Gadgik/vsosh-vertical-plotter/hardware/esp32/block-diagram.pdf

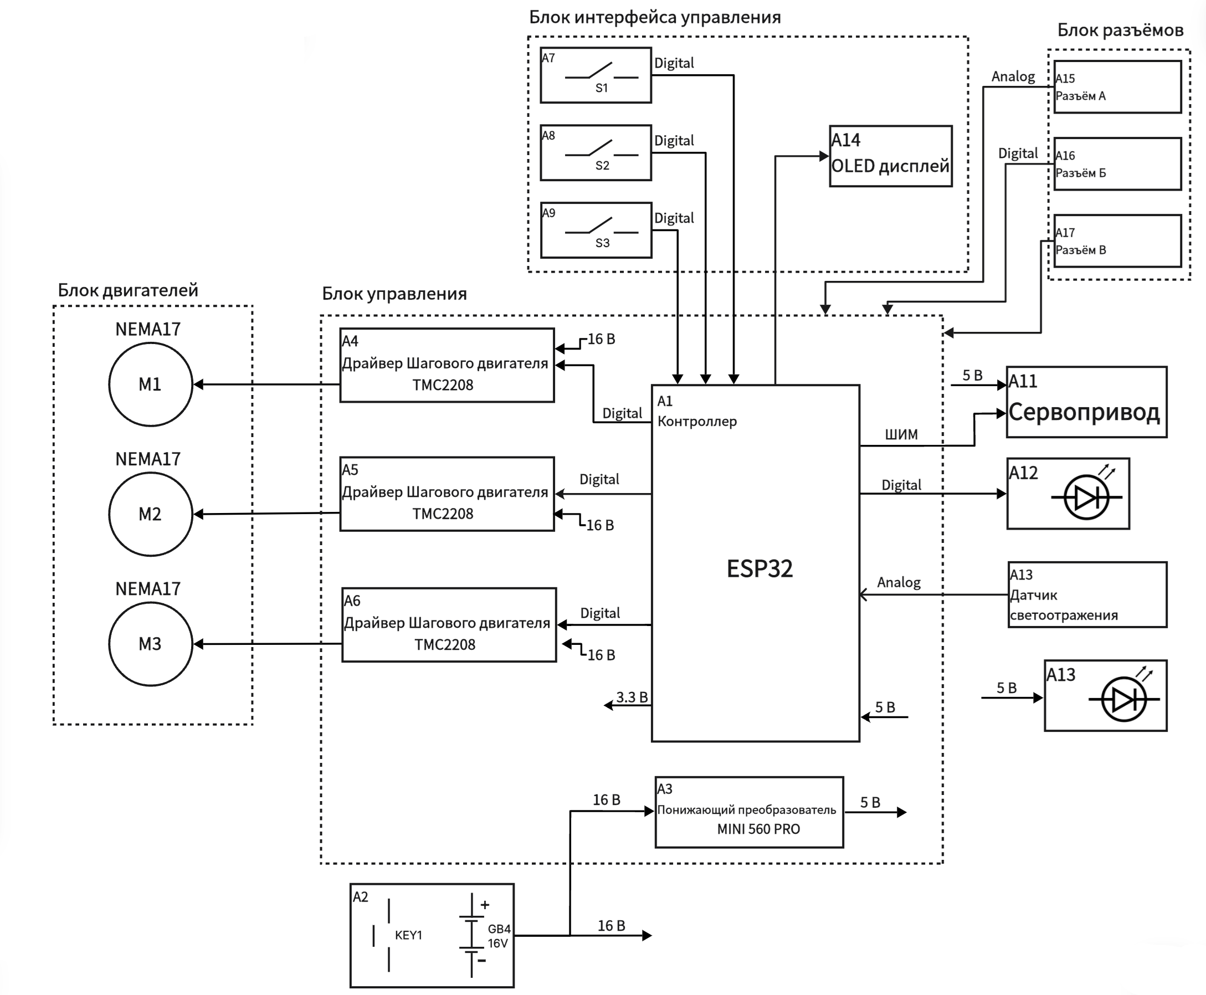
[picture p3: page 1]
