Gadgik/vsosh-vertical-plotter/hardware/PCB1.jpg

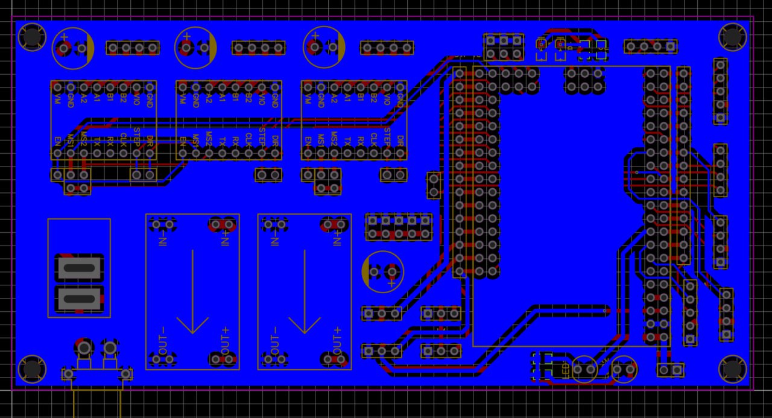
hardware/PCB1.jpg
