Gadgik/vsosh-vertical-plotter/photos/front.jpg

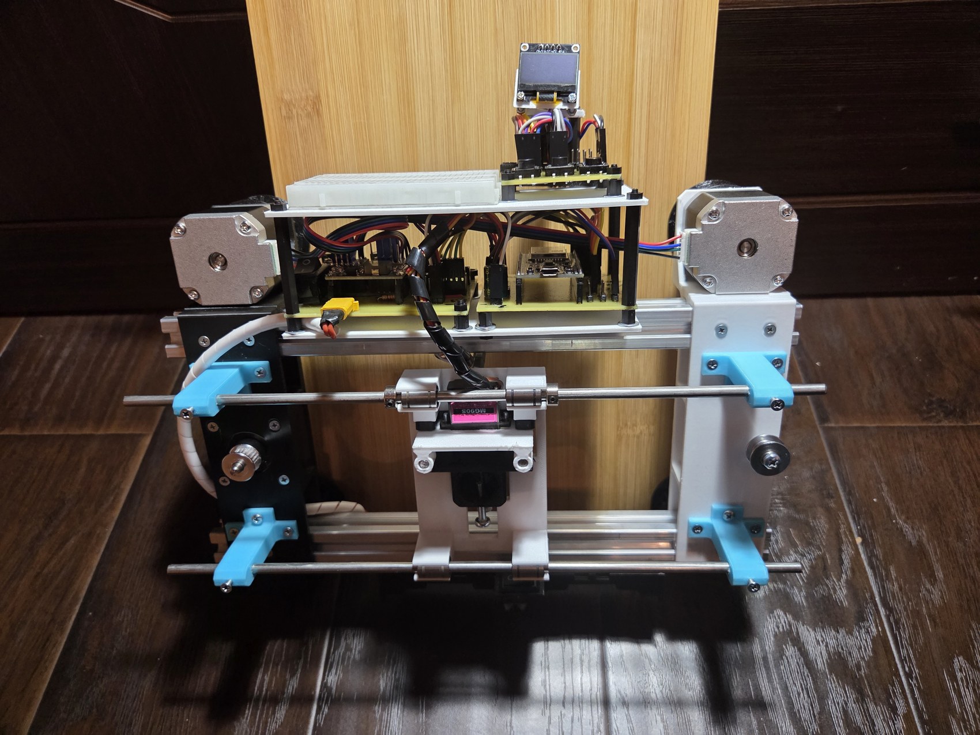
photos/front.jpg
