Gadgik/vsosh-vertical-plotter/photos/perspective.jpg

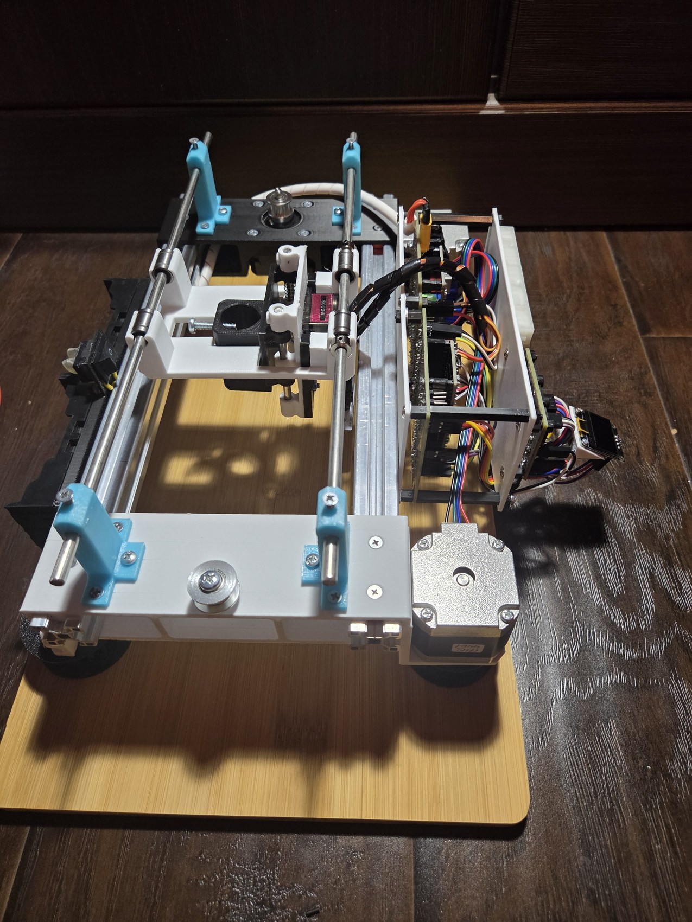
photos/perspective.jpg
