Gadgik/vsosh-vertical-plotter/photos/pic_ (2).jpg

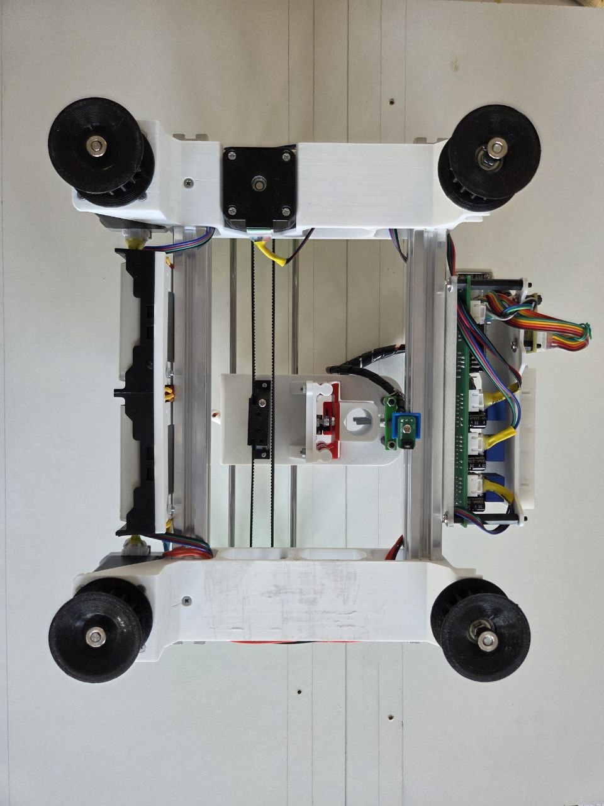
photos/pic_ (2).jpg
