Gadgik/vsosh-vertical-plotter/photos/pic_ (3).jpg

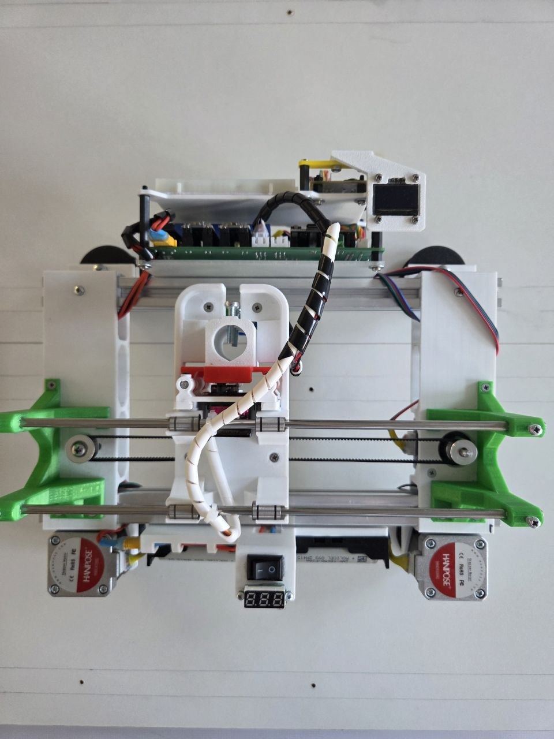
photos/pic_ (3).jpg
