Gadgik/vsosh-vertical-plotter/photos/top.jpg

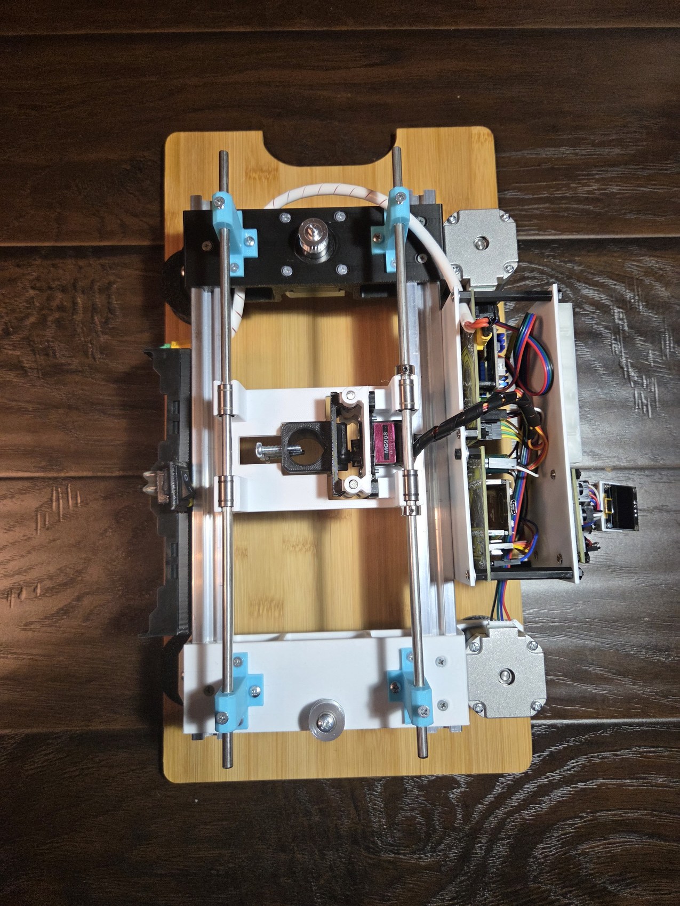
photos/top.jpg
