Gadgik/vsosh-vertical-plotter/photos/underside.jpg

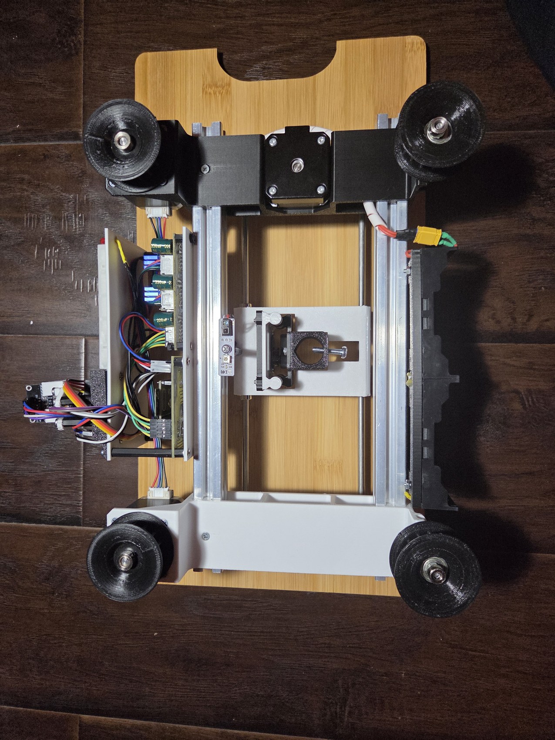
photos/underside.jpg
