Gadgik/vsosh-vertical-plotter/cad/assembly.step

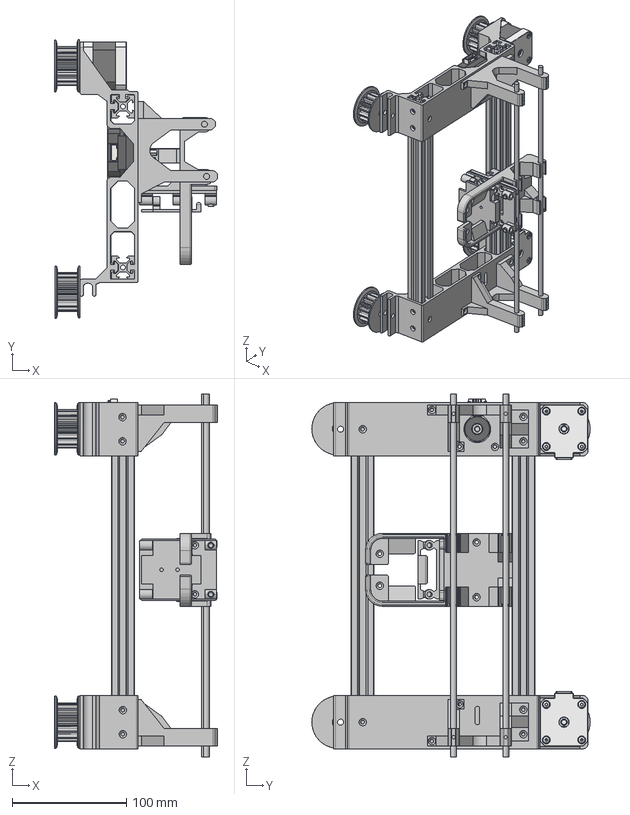
[picture p11: CAD file, 2026-11-09]
cad/assembly.step
143.0 x 244.0 x 318.0 mm
Perfil2020 x 2
back_plate
front_plate
stator
625ZZ x 2
rotor
connector
M3_screw x 4
