Gadgik/vsosh-vertical-plotter/cad/parts/screen_1.stp

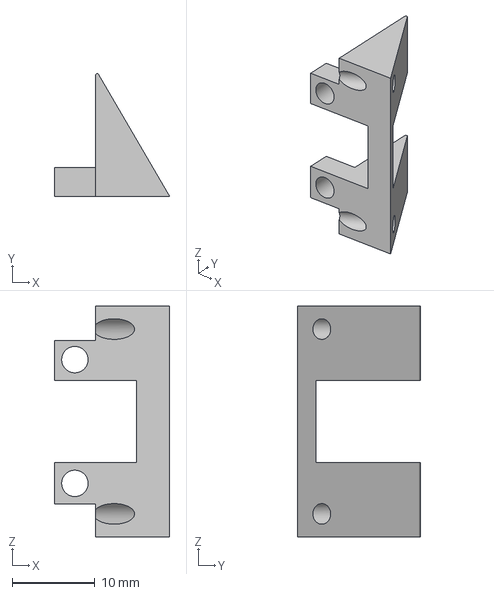
[picture p12: CAD file, 2026-11-09]
cad/parts/screen_1.stp
14.0 x 14.9 x 28.0 mm
