Gadgik/vsosh-vertical-plotter/cad/parts/z_1.stp

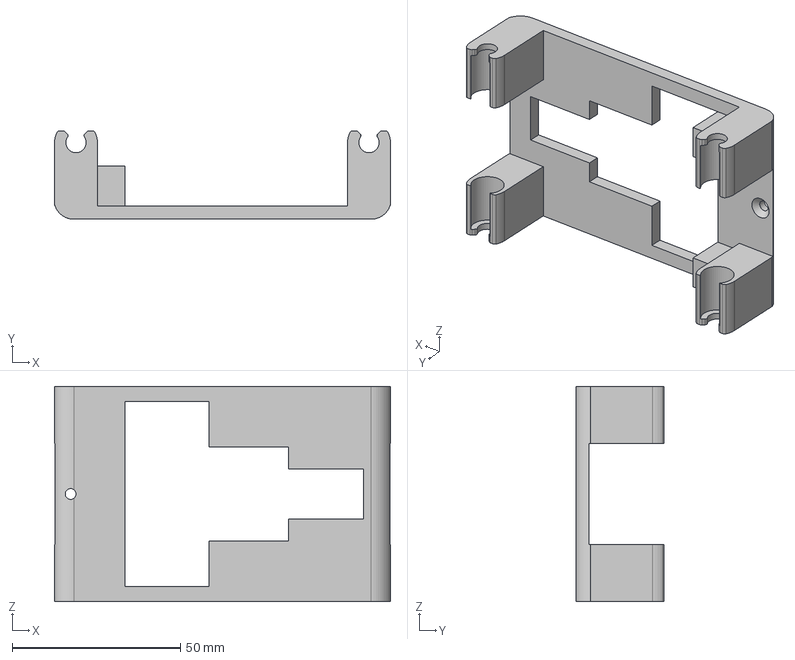
[picture p13: CAD file, 2026-11-09]
cad/parts/z_1.stp
100.0 x 26.3 x 64.0 mm
