Gadgik/vsosh-vertical-plotter/cad/parts/pcb_layer_2.stp

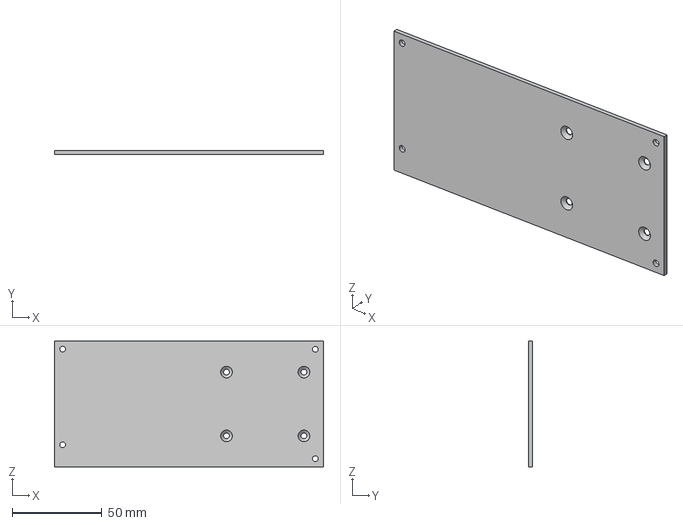
[picture p14: CAD file, 2026-11-09]
cad/parts/pcb_layer_2.stp
150.0 x 2.00 x 70.2 mm
