Gadgik/vsosh-vertical-plotter/cad/parts/Battery_hold.stp

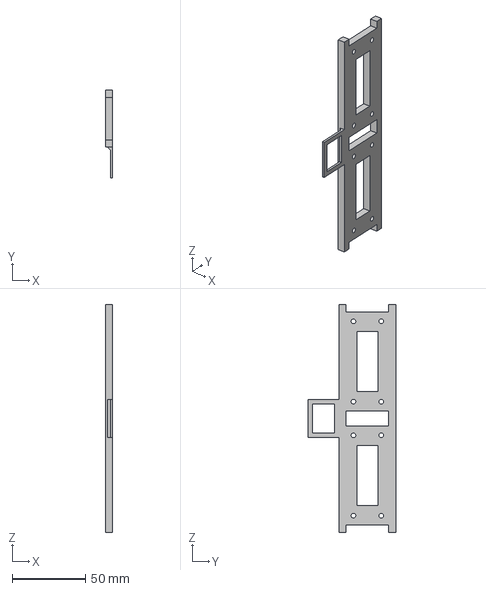
[picture p15: CAD file, 2026-11-09]
cad/parts/Battery_hold.stp
5.00 x 60.0 x 156.0 mm
