Gadgik/vsosh-vertical-plotter/cad/parts/z_5.stp

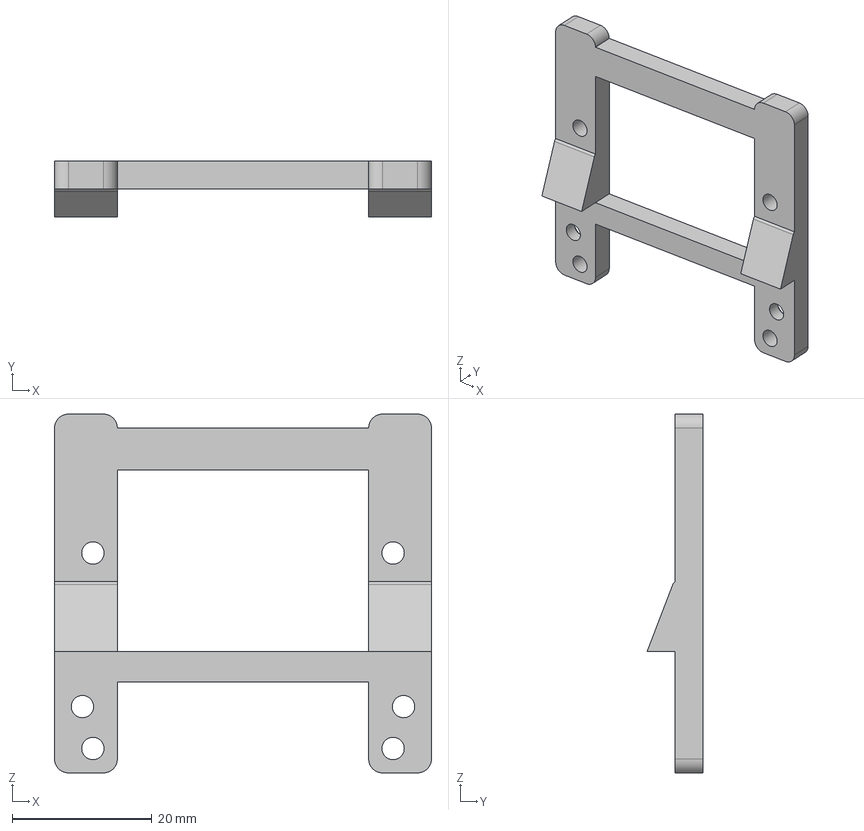
[picture p16: CAD file, 2026-11-09]
cad/parts/z_5.stp
54.0 x 8.00 x 51.4 mm
