Gadgik/vsosh-vertical-plotter/cad/parts/rail_holder.stp

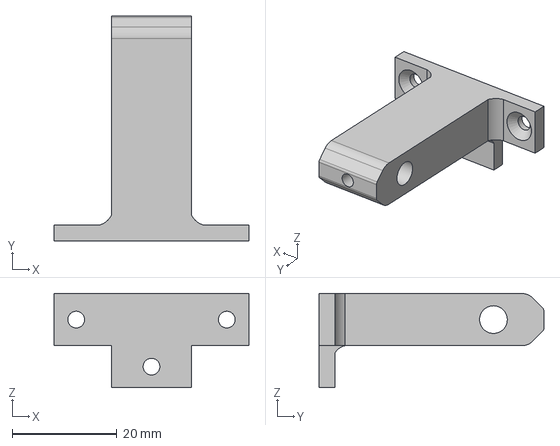
[picture p18: CAD file, 2026-11-09]
cad/parts/rail_holder.stp
37.3 x 43.0 x 18.0 mm
