Gadgik/vsosh-vertical-plotter/cad/parts/z_4.stp

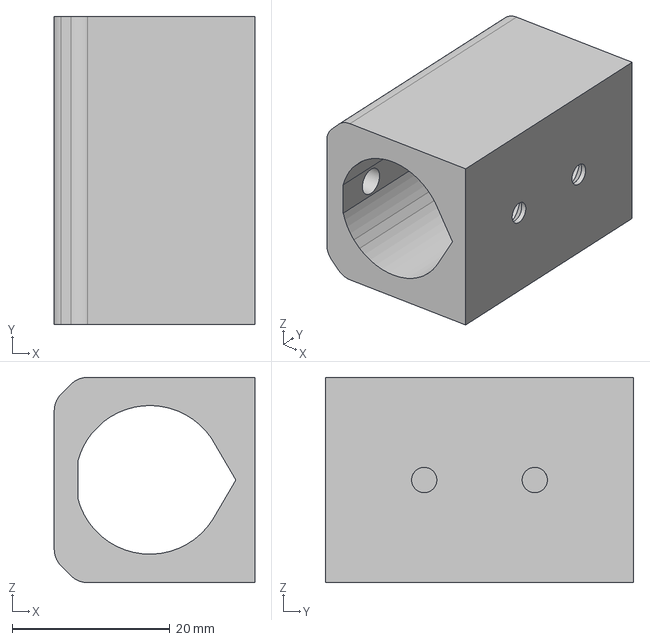
[picture p19: CAD file, 2026-11-09]
cad/parts/z_4.stp
25.4 x 39.0 x 26.0 mm
