Gadgik/vsosh-vertical-plotter/cad/parts/gear_motor.stp

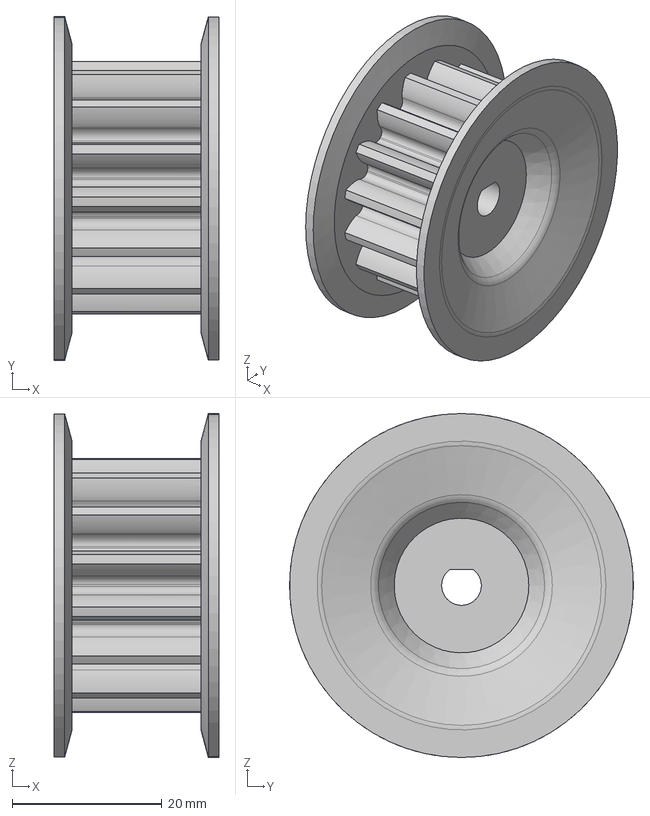
[picture p20: CAD file, 2026-11-09]
cad/parts/gear_motor.stp
22.0 x 46.0 x 46.0 mm
