Gadgik/vsosh-vertical-plotter/cad/parts/gear_op.stp

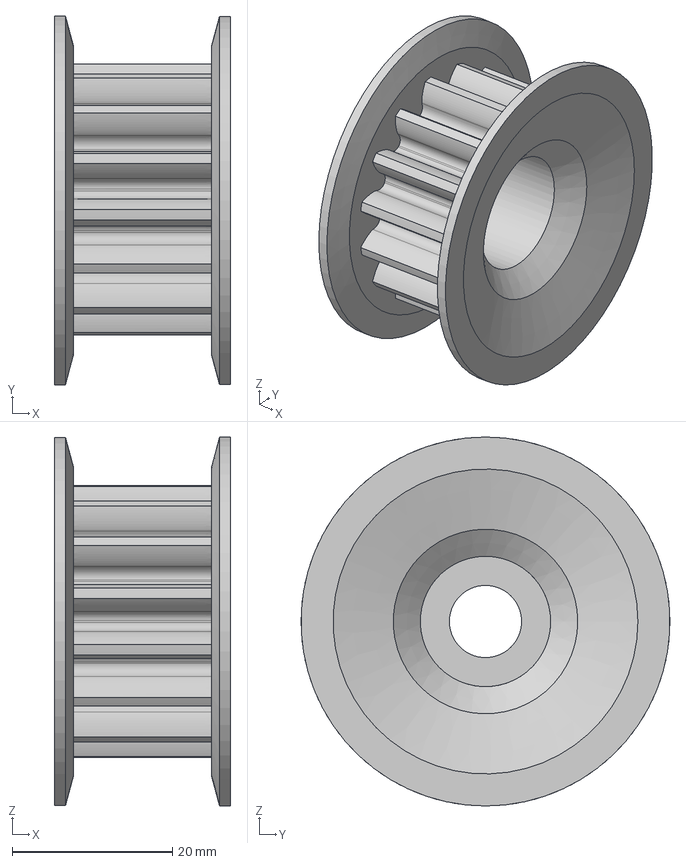
[picture p21: CAD file, 2026-11-09]
cad/parts/gear_op.stp
22.0 x 46.0 x 46.0 mm
