Gadgik/vsosh-vertical-plotter/cad/parts/motor_holder_R_2.stp

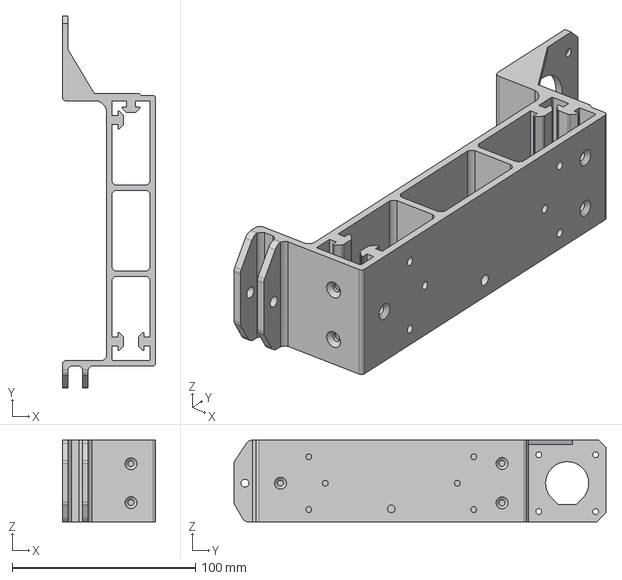
[picture p22: CAD file, 2026-11-09]
cad/parts/motor_holder_R_2.stp
50.8 x 202.9 x 44.7 mm
