Gadgik/vsosh-vertical-plotter/cad/parts/screen_2.stp

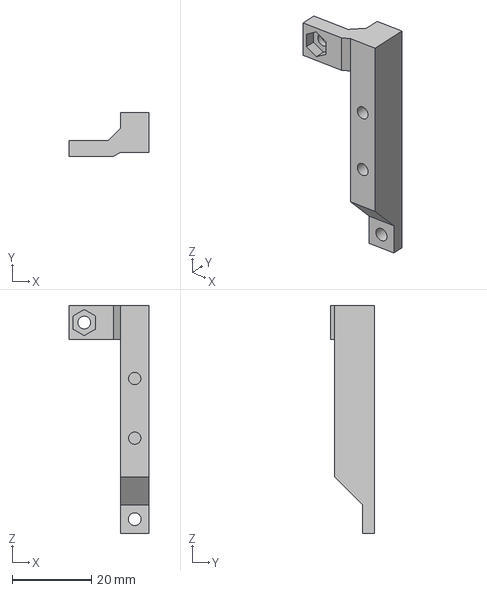
[picture p23: CAD file, 2026-11-09]
cad/parts/screen_2.stp
20.2 x 11.0 x 57.4 mm
