Gadgik/vsosh-vertical-plotter/cad/parts/z_2.stp

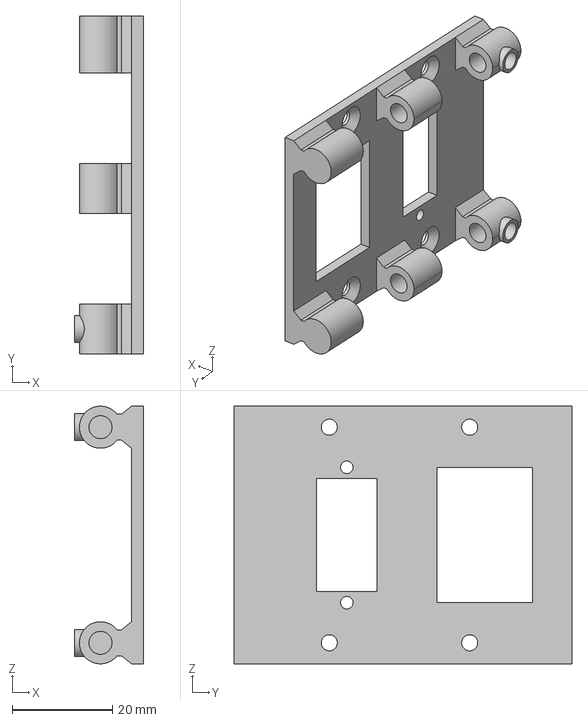
[picture p24: CAD file, 2026-11-09]
cad/parts/z_2.stp
13.8 x 67.4 x 51.4 mm
