Gadgik/vsosh-vertical-plotter/cad/parts/z_3.stp

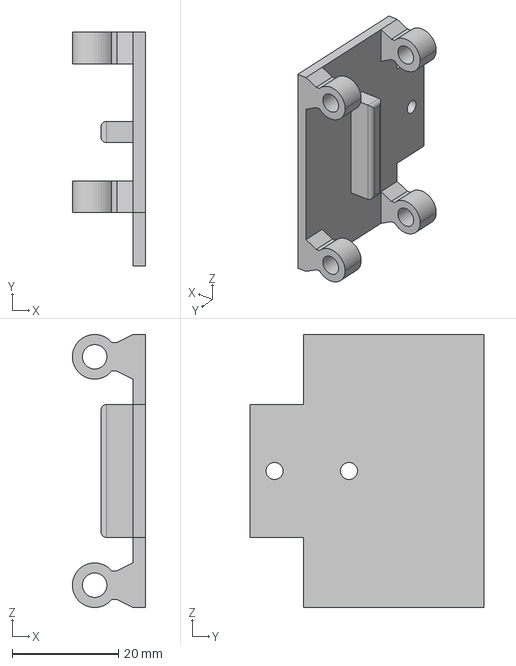
[picture p25: CAD file, 2026-11-09]
cad/parts/z_3.stp
13.8 x 44.0 x 51.4 mm
