Gadgik/vsosh-vertical-plotter/cad/parts/t_nut_m3.stp

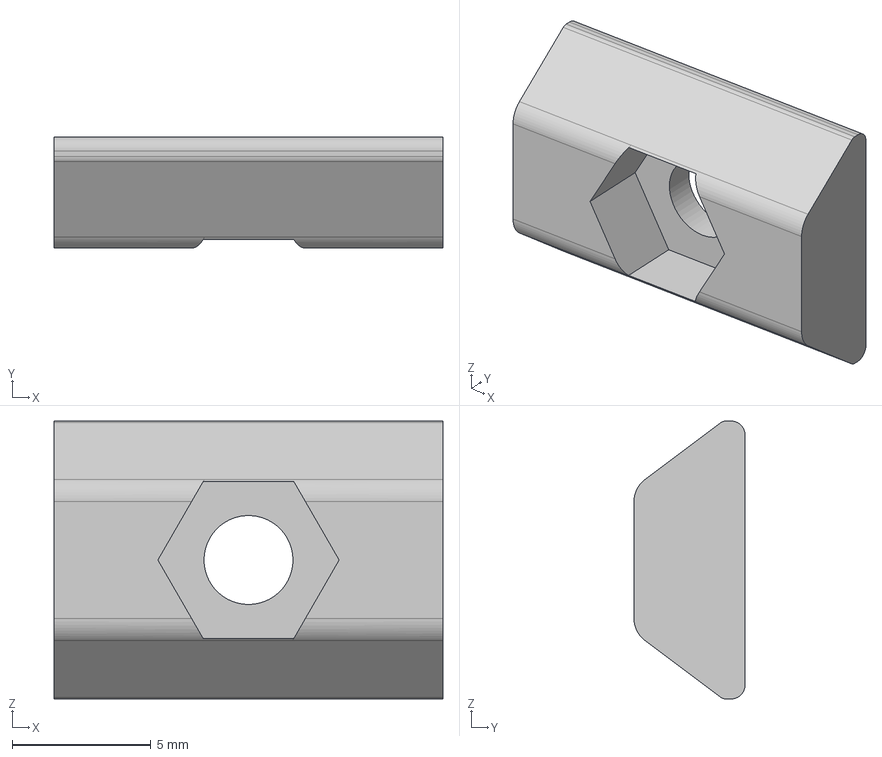
[picture p26: CAD file, 2026-11-09]
cad/parts/t_nut_m3.stp
14.0 x 4.00 x 10.0 mm
