Gadgik/vsosh-vertical-plotter/(list of files, cad)

Other CAD files:
cad/parts/pcb_layer_1.stp
