Gadgik/vsosh-vertical-plotter/hardware/E1-block-diagram.pdf

A9

A17

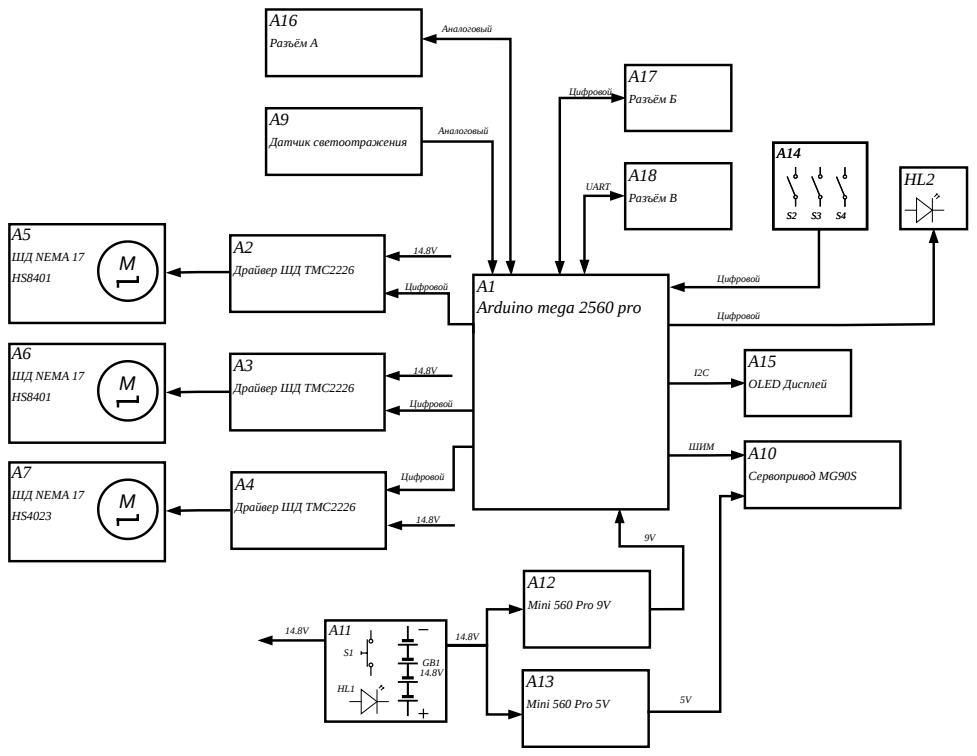
[picture p27: page 1]
Драйвер ШД TMC2226; Mini 560 Pro 9V; ШД NEMA 17; Mini 560 Pro 5V; Датчик светоотражения; Сервопривод MG90S; Разъём Б; Разъём В; OLED Дисплей; ШИМ; Цифровой; Аналоговый; UART; Разъём А

Arduino mega 2560 pro
