Gadgik/vsosh-vertical-plotter/hardware/esp32/schematic.pdf

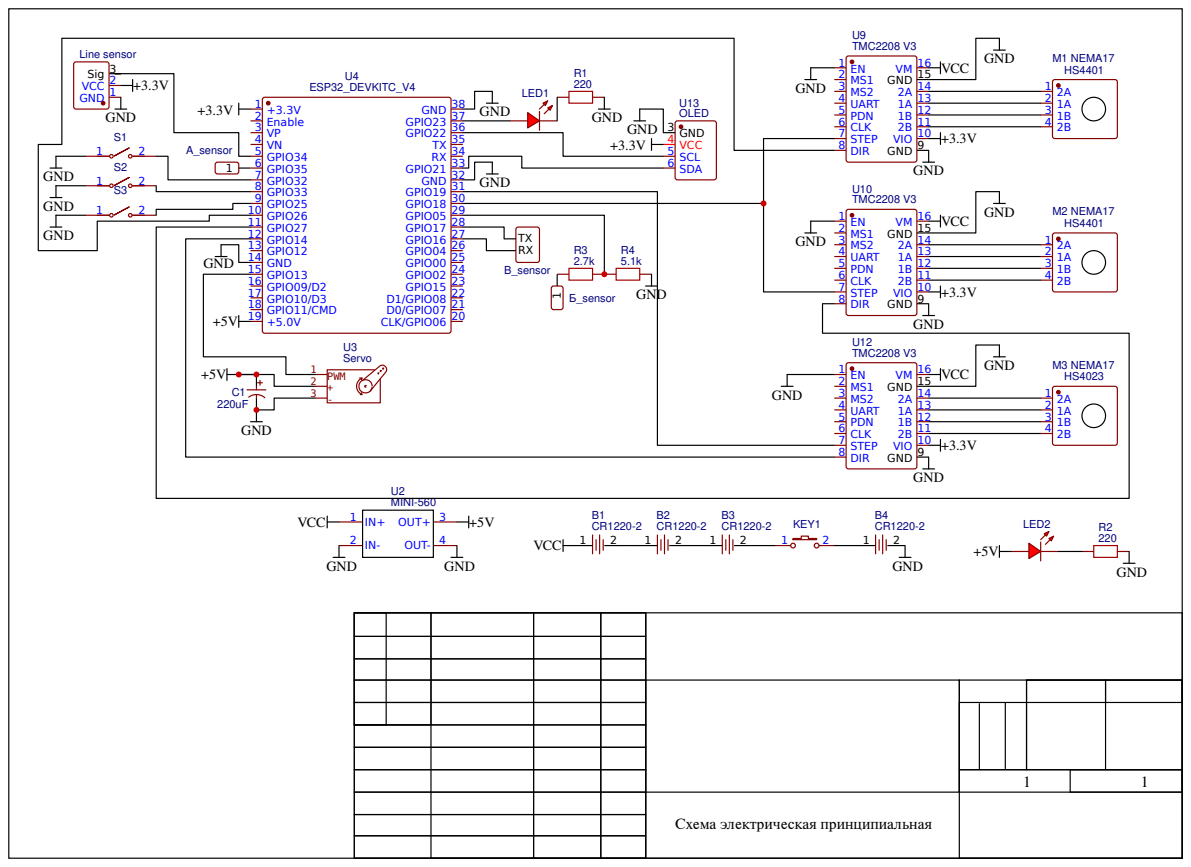
[picture p28: page 1]

CLK/GPIO06 20 +5.0V 19 GPIO11/CMD 18 GPIO10/D3 17 GPIO09/D2 16 GPIO13 15 GND 14 GPIO12 13 GPIO14 12 GPIO27 11 GPIO26 10 GPIO25 9 GPIO33 8 GPIO32 7 GPIO35 6 GPIO34 5 VN 4 VP 3 Enable 2 +3.3V 1
